Guili-Lopes/Controle-PI-para-Exaustao-de-Fumaca/Resultados_Simulacao_Matlab/resumo_metricas.csv

Caso | Subida_s | Acomodacao_s | Sobressinal_pct | IAE_150_240 | Saida_em_240 | PWM_final_pct
Ideal - Euler | 14.8104261301917 | 26.5 | 1.5030802401787 | 5.18172105757154 | -0.300997024153286 | 80.0182449208363
Saturado - Euler | 15.9164203324089 | 40.9 | 2.87951900353406 | 14.6075064733264 | -0.34604398702661 | 80.6251063718292
Back-Calc - Euler | 16.3338103038947 | 28.6 | 0.85682499054468 | 2.87210652934605 | -0.30049641424013 | 80.0094278320375
Clamping - Euler | 15.9164203324089 | 40.9 | 2.87951900353406 | 2.94614611063667 | -0.300739393251126 | 80.0123987502541
Back-Calc - Tustin antigo | 16.3383704006277 | 28.6 | 0.890644352395405 | 2.87731619026426 | -0.300497743009154 | 80.0091874859301
