Guili-Lopes/Controle-PI-para-Exaustao-de-Fumaca/Resultados_Simulacao_Simulink/metricas.csv

Controlador | IAE_150_a_240 | Saida_Final | PWM_Final_pct
PI ideal | 5.18172105757155 | -0.300997024153286 | 80.0182449208363
Saturado sem AW | 14.6075064733264 | -0.346043987026609 | 80.6251063718292
Back-Calculation | 2.87210652934606 | -0.30049641424013 | 80.0094278320374
Clamping | 2.94614611063667 | -0.300739393251126 | 80.0123987502541
