Guili-Lopes/Controle-PI-para-Exaustao-de-Fumaca/Resultados_Simulacao_Matlab/ComparacaoPI.png

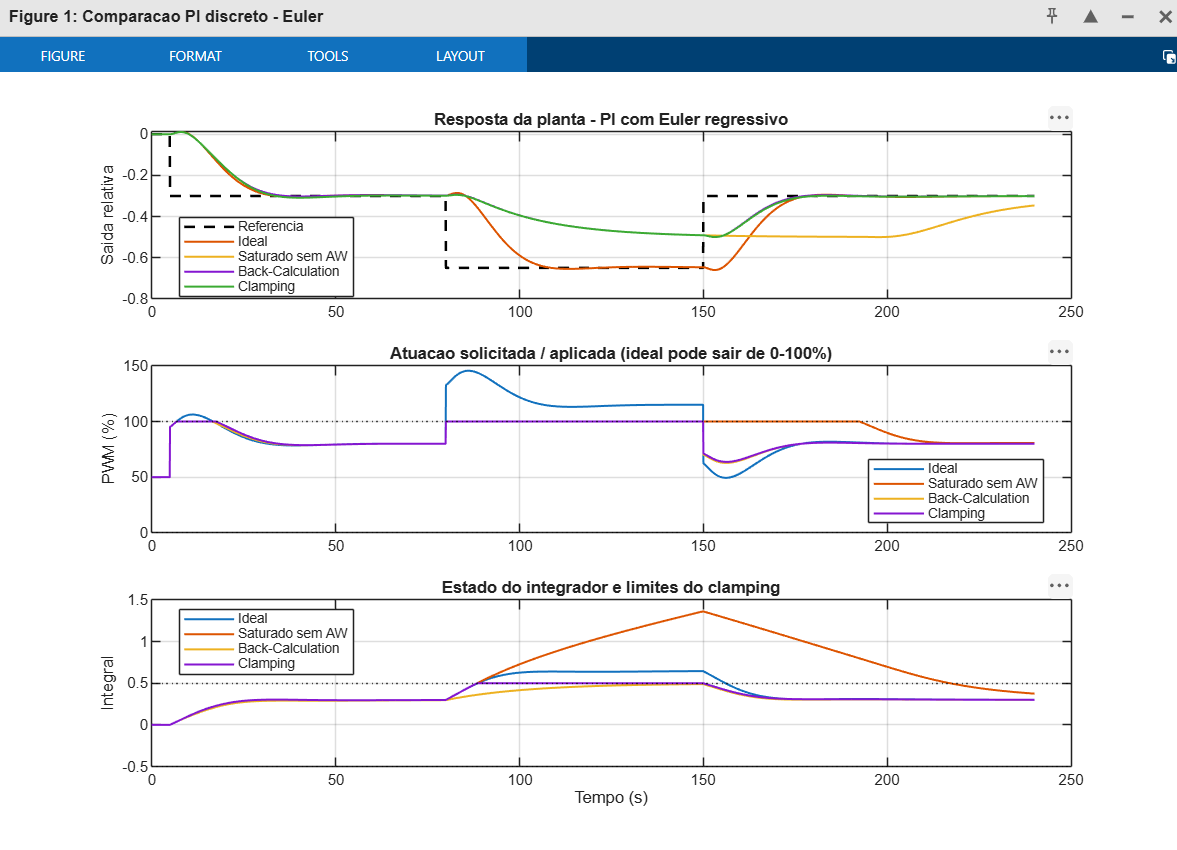
Resultados_Simulacao_Matlab/ComparacaoPI.png
