Guili-Lopes/Controle-PI-para-Exaustao-de-Fumaca/Resultados_Simulacao_Matlab/RecuperacaoSaturacao.png

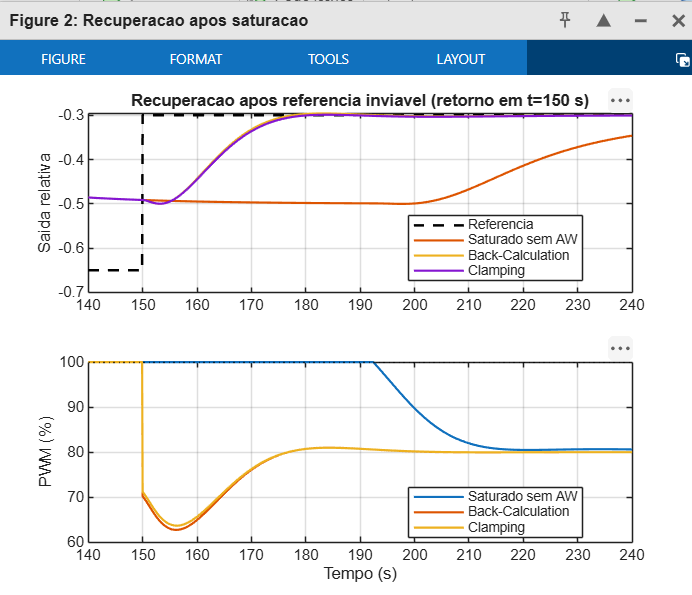
Resultados_Simulacao_Matlab/RecuperacaoSaturacao.png
