Guili-Lopes/Controle-PI-para-Exaustao-de-Fumaca/Resultados_Simulacao_Simulink/PI_Matlab.png

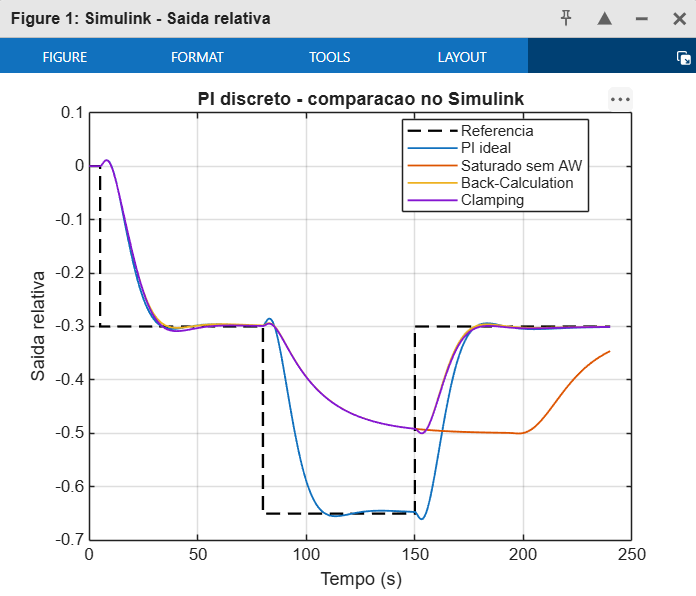
Resultados_Simulacao_Simulink/PI_Matlab.png
