Guili-Lopes/Controle-PI-para-Exaustao-de-Fumaca/Resultados_Simulacao_Simulink/PWM_Duty_Matlab.png

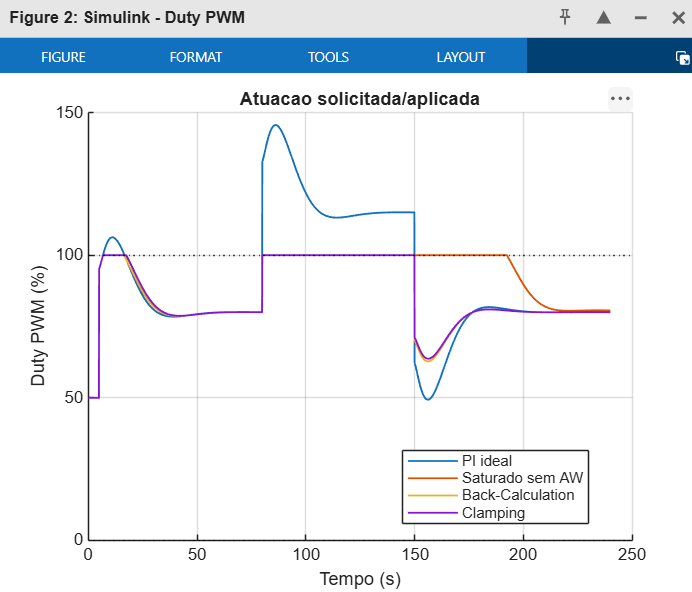
Resultados_Simulacao_Simulink/PWM_Duty_Matlab.png
