Guili-Lopes/Controle-PI-para-Exaustao-de-Fumaca/Resultados_Simulacao_Simulink/Termo_Integral_Matlab.png

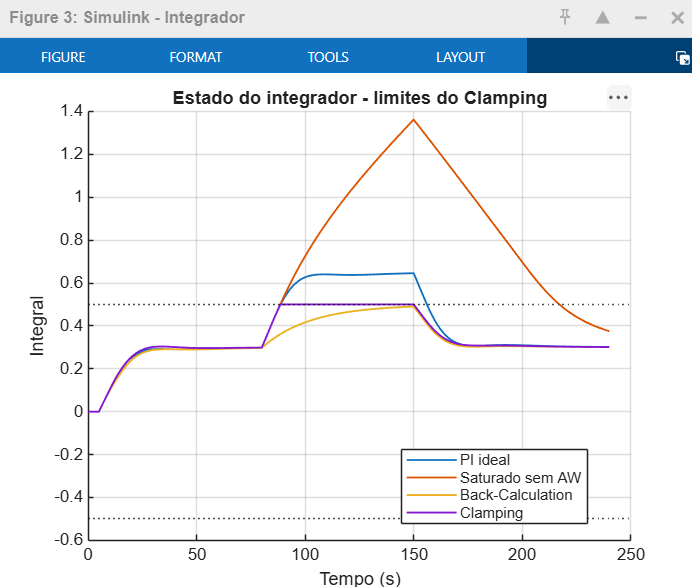
Resultados_Simulacao_Simulink/Termo_Integral_Matlab.png
