Guili-Lopes/Controle-PI-para-Exaustao-de-Fumaca/Esquemático_KiCad/Esquemático.pdf

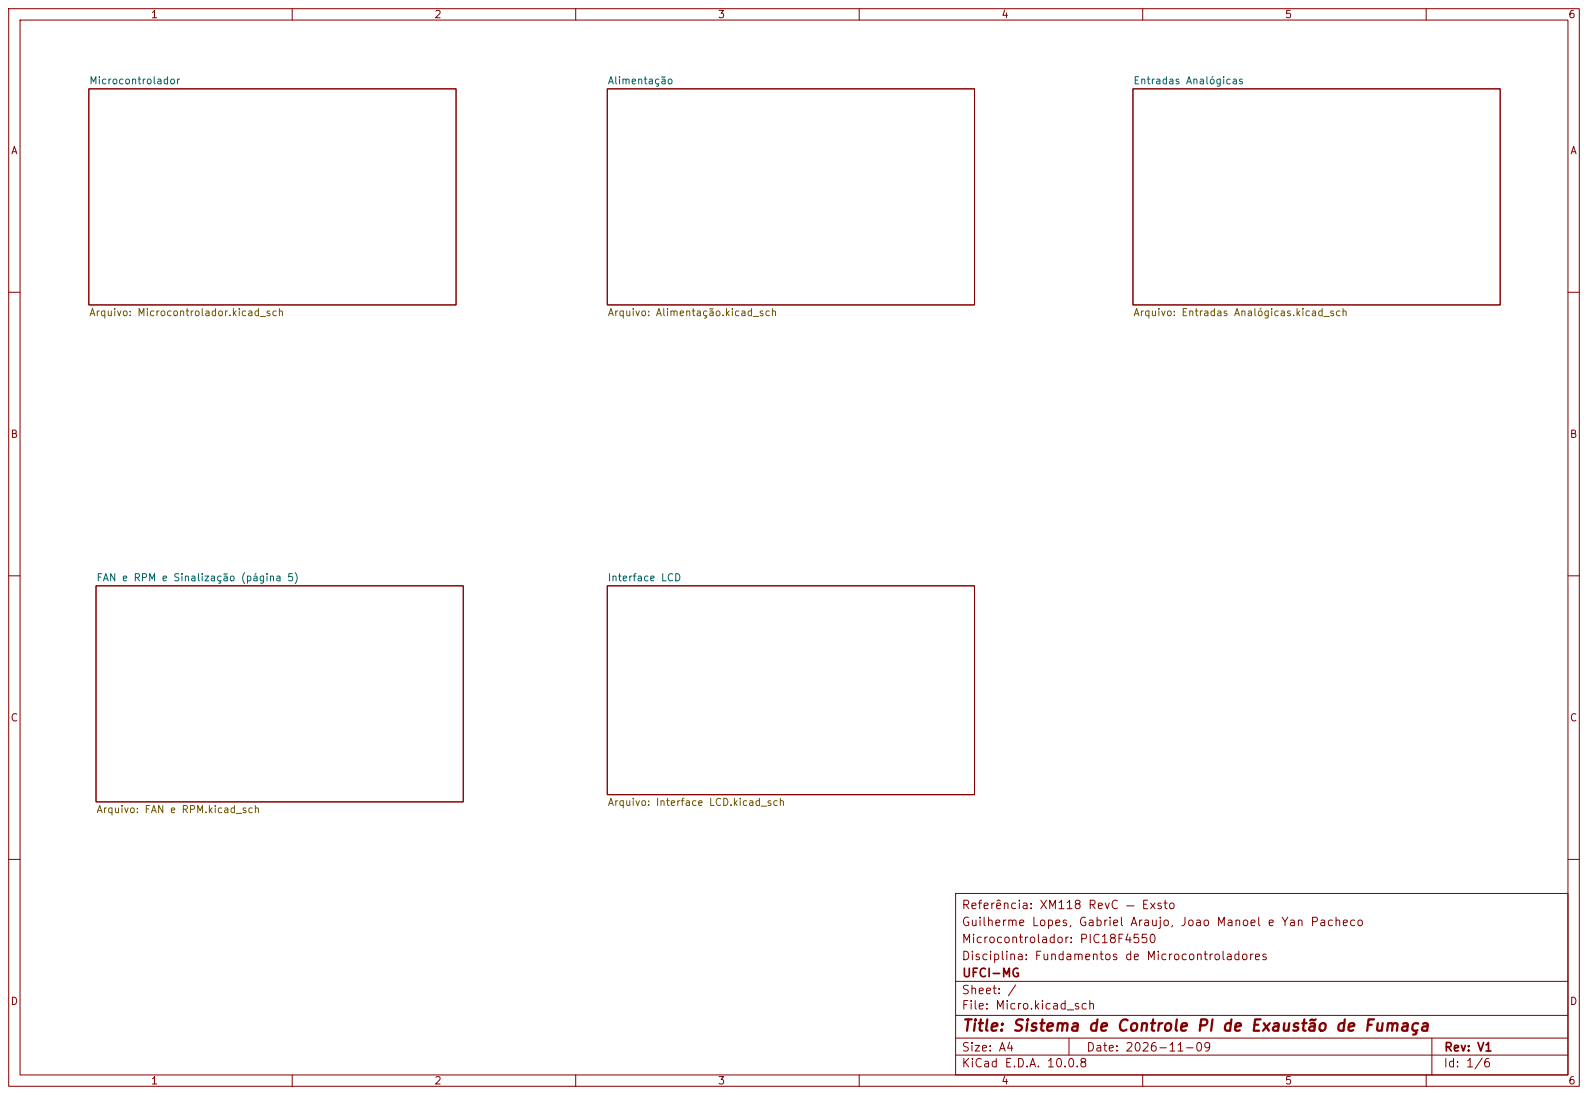
[picture p9: page 1]

FAN e RPM e Sinalização (página 5)

Referência: XM118 RevC — Exsto
Guilherme Lopes, Gabriel Araujo, Joao Manoel e Yan Pacheco
Microcontrolador: PIC18F4550
Disciplina: Fundamentos de Microcontroladores
UFCI-MG
Sheet: /
File: Micro.kicad_sch
Title: Sistema de Controle PI de Exaustão de Fumaça

Size: A4 | Rev: V1
KiCad E.D.A. 10.0.8 | Id: 1/6

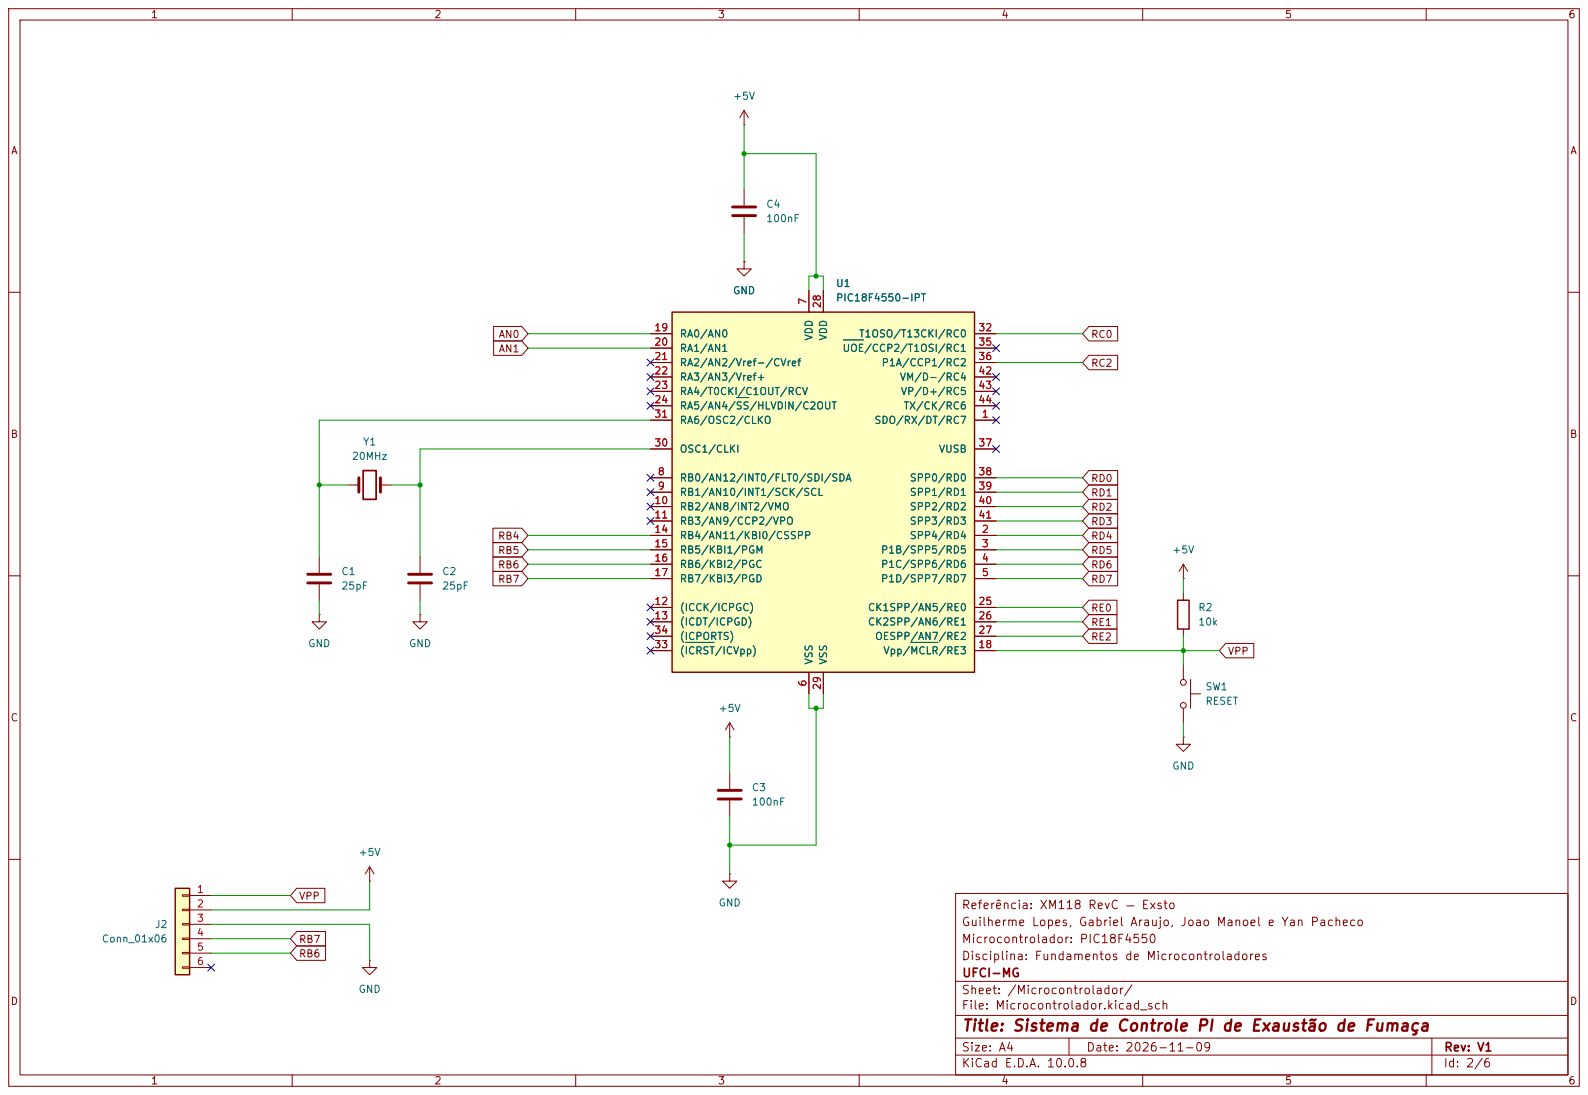
[picture p10: page 2]

7 RB0/AN12/INT0/FLT0/SDI/SDA 8 RB1/AN10/INT1/SCK/SCL 9 RB2/AN8/INT2/VMO 10 RB3/AN9/CCP2/VPO 11

Referência: XM118 RevC — Exsto
Guilherme Lopes, Gabriel Araujo, Joao Manoel e Yan Pacheco
Microcontrolador: PIC18F4550
Disciplina: Fundamentos de Microcontroladores
UFCI-MG
Sheet: /Microcontrolador/
File: Microcontrolador.kicad_sch
Title: Sistema de Controle PI de Exaustão de Fumaça

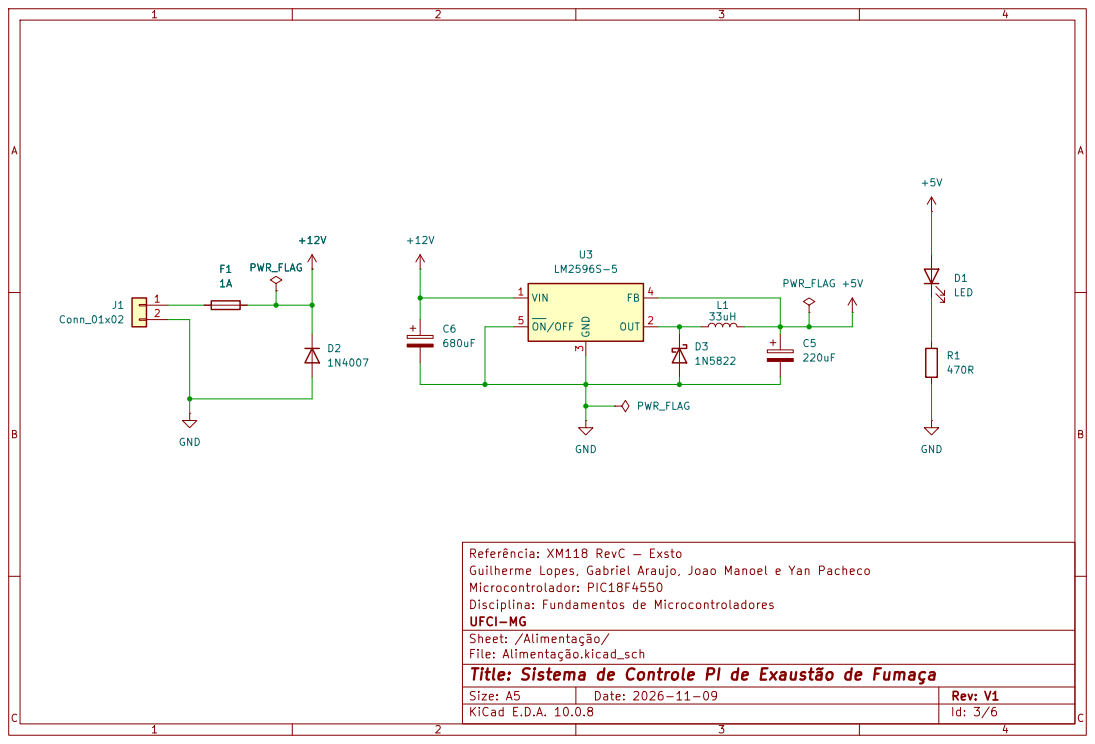
[picture p11: page 3]

Guilherme Lopes, Gabriel Araujo, Joao Manoel e Yan Pacheco
Microcontrolador: PIC18F4550
Disciplina: Fundamentos de Microcontroladores
UFCI-MG
Sheet: /Alimentação/
File: Alimentação.kicad_sch
Title: Sistema de Controle PI de Exaustão de Fumaça

Size: A5 | Rev: V1 | C Date: 2026-11-09
KiCad E.D.A. 10.0.8 | Id: 3/6

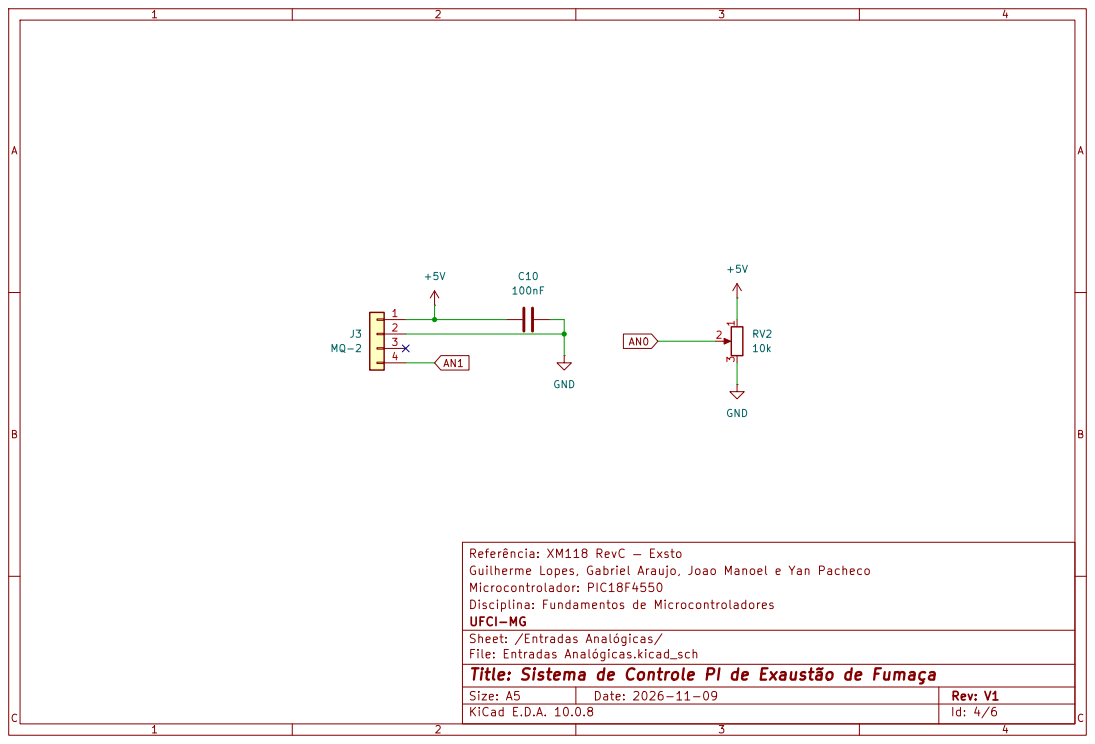
[picture p12: page 4]

Referência: XM118 RevC — Exsto
Guilherme Lopes, Gabriel Araujo, Joao Manoel e Yan Pacheco
Microcontrolador: PIC18F4550
Disciplina: Fundamentos de Microcontroladores
UFCI-MG
Sheet: /Entradas Analógicas/
File: Entradas Analógicas.kicad_sch
Title: Sistema de Controle PI de Exaustão de Fumaça

Size: A5 | Rev: V1 | C Date: 2026-11-09
KiCad E.D.A. 10.0.8 | Id: 4/6

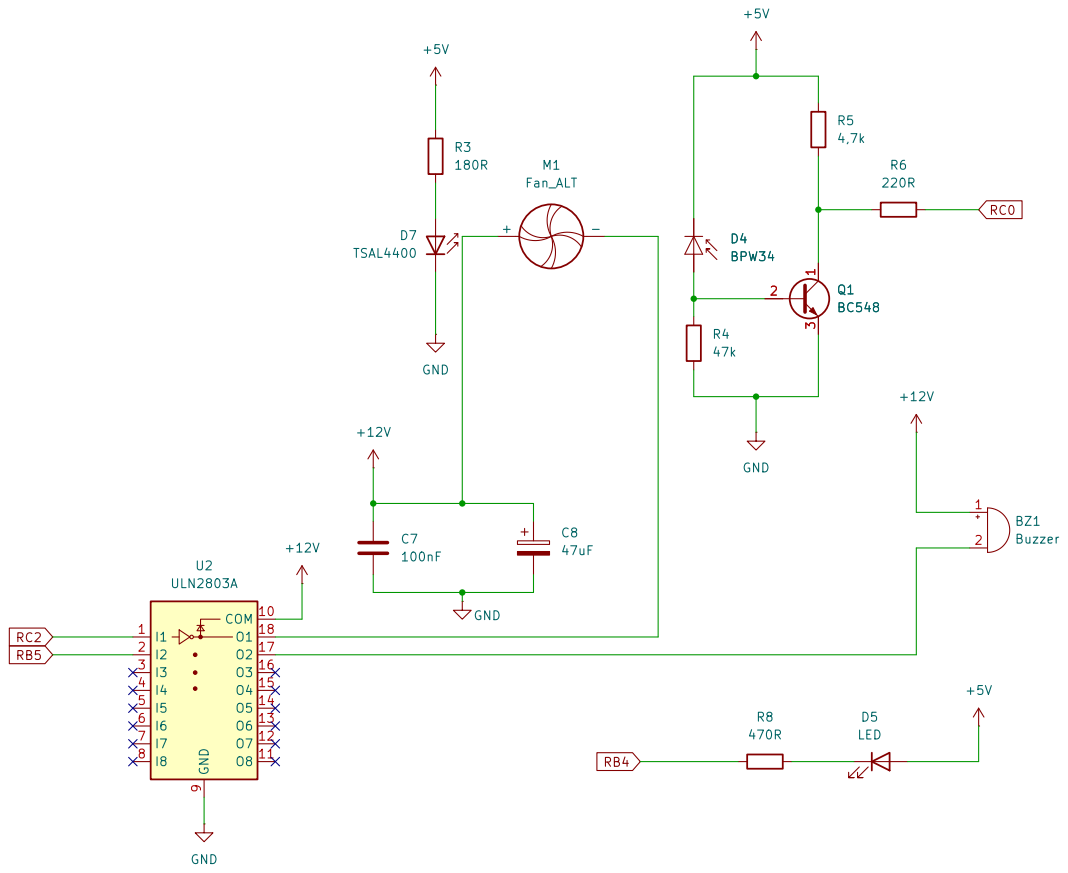
[picture p13: page 5]

Referência: XM118 RevC — Exsto
Guilherme Lopes, Gabriel Araujo, Joao Manoel e Yan Pacheco
Microcontrolador: PIC18F4550
Disciplina: Fundamentos de Microcontroladores
UFCI-MG
Sheet: /FAN e RPM e Sinalização (página 5)/
File: FAN e RPM.kicad_sch
Title: Sistema de Controle PI de Exaustão de Fumaça

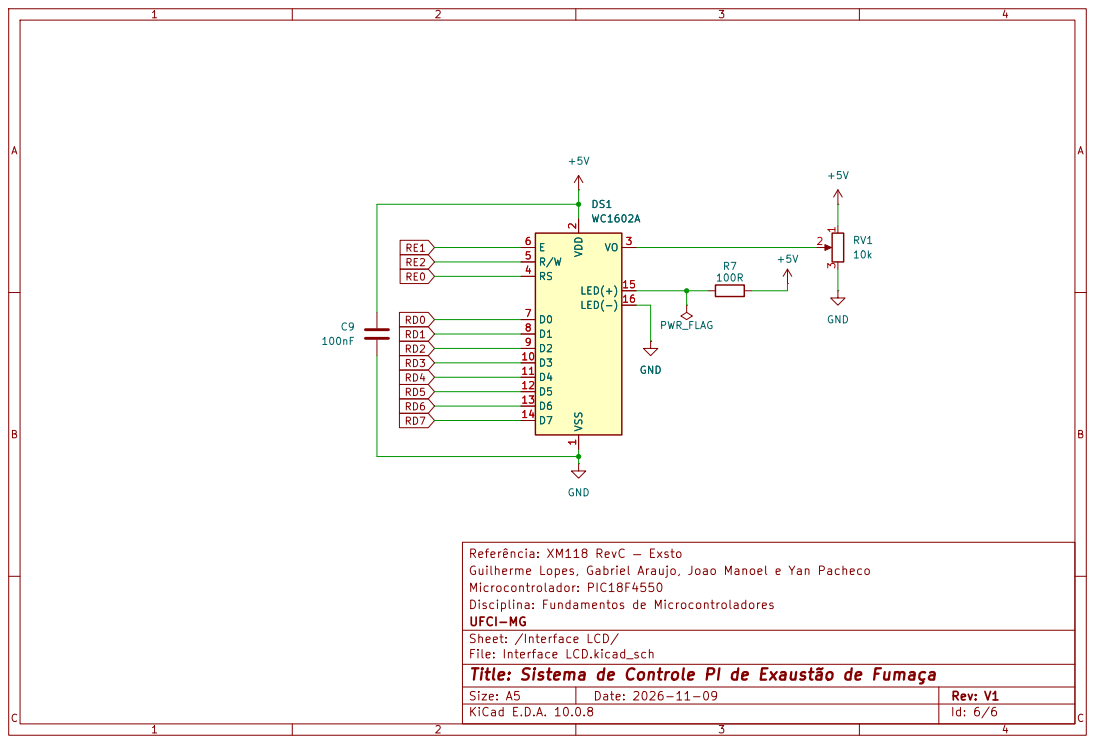
[picture p14: page 6]

Referência: XM118 RevC — Exsto
Guilherme Lopes, Gabriel Araujo, Joao Manoel e Yan Pacheco
Microcontrolador: PIC18F4550
Disciplina: Fundamentos de Microcontroladores
UFCI-MG
Sheet: /Interface LCD/
File: Interface LCD.kicad_sch
Title: Sistema de Controle PI de Exaustão de Fumaça

Size: A5 | Rev: V1 | C Date: 2026-11-09
KiCad E.D.A. 10.0.8 | Id: 6/6
