Guili-Lopes/Controle-PI-para-Exaustao-de-Fumaca/(commit log)

2026-11-11 Comitando os arquivos do projeto
    [Alimentação.kicad_sch, Entradas Analógicas.kicad_sch, FAN e RPM.kicad_sch, Interface LCD.kicad_sch, Micro.kicad_pcb, Micro.kicad_sch, Microcontrolador.kicad_sch, Sinalização.kicad_sch]
2026-11-12 Adicionando opcao para simulacao no PicSimLab
